easy-smart/stm32f1_nano/software/flasheuitest/README.md

# STM32F4 Uno flasheuitest

This test program is used to check the flash chip on SPI1. The chip used is a `SST26VF016BEUI-104I/SN` 16Mbit NOR-Flash
with EUI.

First, the EUI is written to SWO. Then a storage device is presented over USB where a file can be stored to the flash.

The blue LED pulses.
