easy-smart/stm32f1_nano/software/flashtest/README.md

# STM32F4 Uno flashtest

This test program is used to check the flash chip on SPI1. The chip used is a `W25Q128JVSIQ` 128Mbit NOR-Flash.

A storage device is presented over USB where a file can be stored to the flash.
