easy-smart/stm32f1_nano/production_jlcpcb_stm32f1_nano_2023-08-24_13-40-17/STM32F1 Nano Pinout.pdf

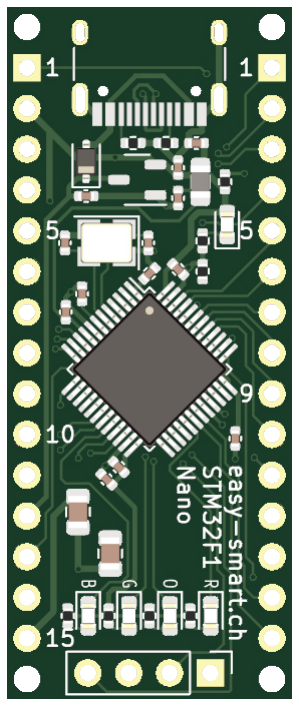
[picture p3: figure]

PB14
PB15
PB12
PC13
PB9
PB8
PB7
PB6
PB5
PB4
PA15
GND

PA10
PA9

DIO

CLK

SWO

GND

PB13
3V3

PA0
PA1
PA2
PA3
PB11
PB10
PB0
PB1

(from USB or LDO) 5V
nRST
GND

(4.8V..15.3V) V

# STM32F1 Nano v1.0.1

Software-Entwicklung
Informatik
3D-Druck
Elektronik
Automatisierung
