easy-smart/stm32f1_nano/production/jlcpcb_STM32F1_Nano_1.1.0_2023-10-03_12-36-29/Produce_DanZhi.SMT_Original_Snapshot.Top.4825844A_Y17.SMT02310031417711.png

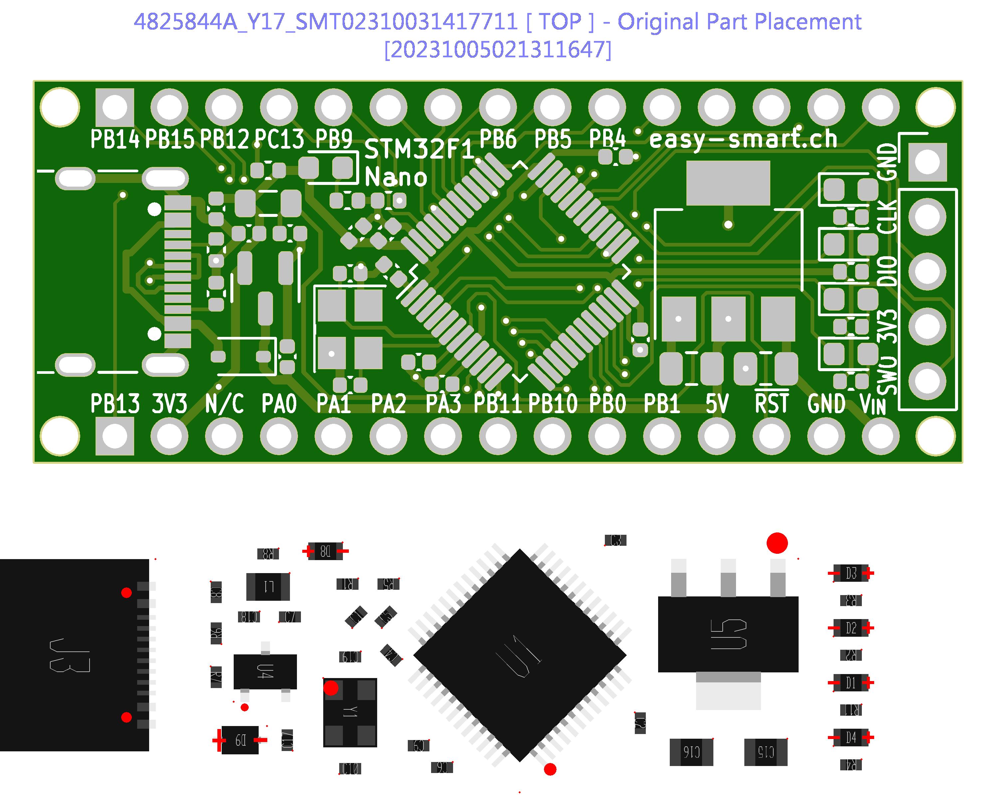
production/jlcpcb_STM32F1_Nano_1.1.0_2023-10-03_12-36-29/Produce_DanZhi.SMT_Original_Snapshot.Top.4825844A_Y17.SMT02310031417711.png
