easy-smart/stm32f1_nano/production/jlcpcb_STM32F1_Nano_1.1.0_2023-10-03_12-36-29/PXL_20240223_161416495.jpg

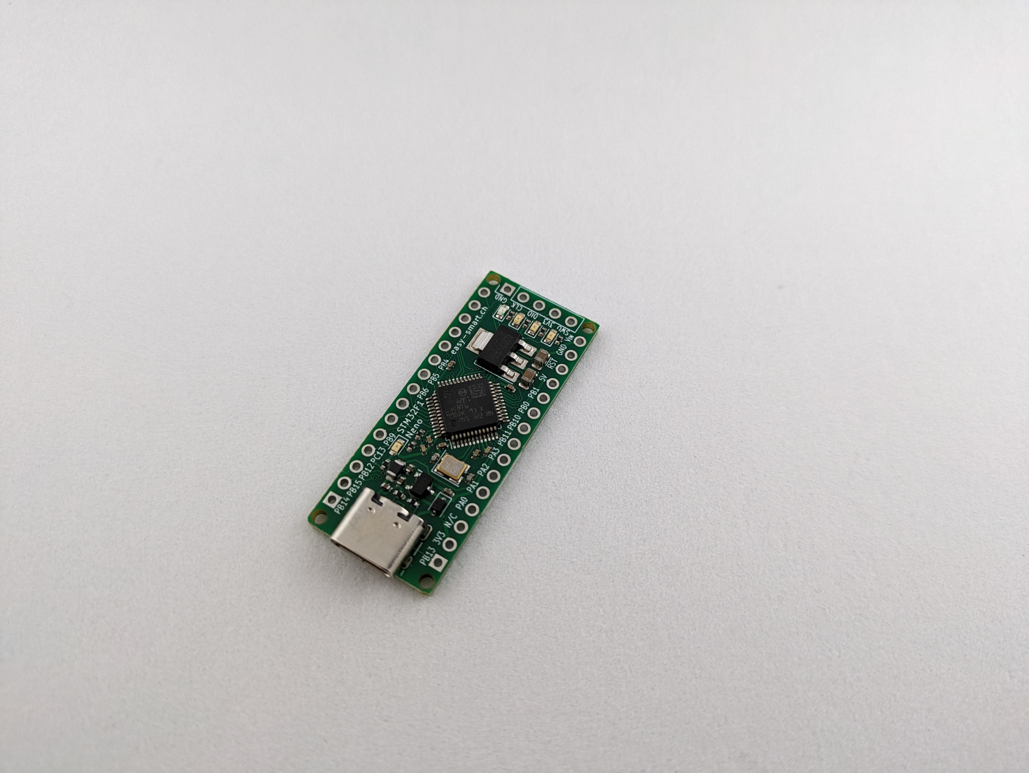
production/jlcpcb_STM32F1_Nano_1.1.0_2023-10-03_12-36-29/PXL_20240223_161416495.jpg
