easy-smart/stm32f1_nano/production_jlcpcb_stm32f1_nano_2023-08-24_13-40-17/Produce_DanZhi.SMT_Snapshot.Top.4825844A_Y10.SMT02308241367407.png

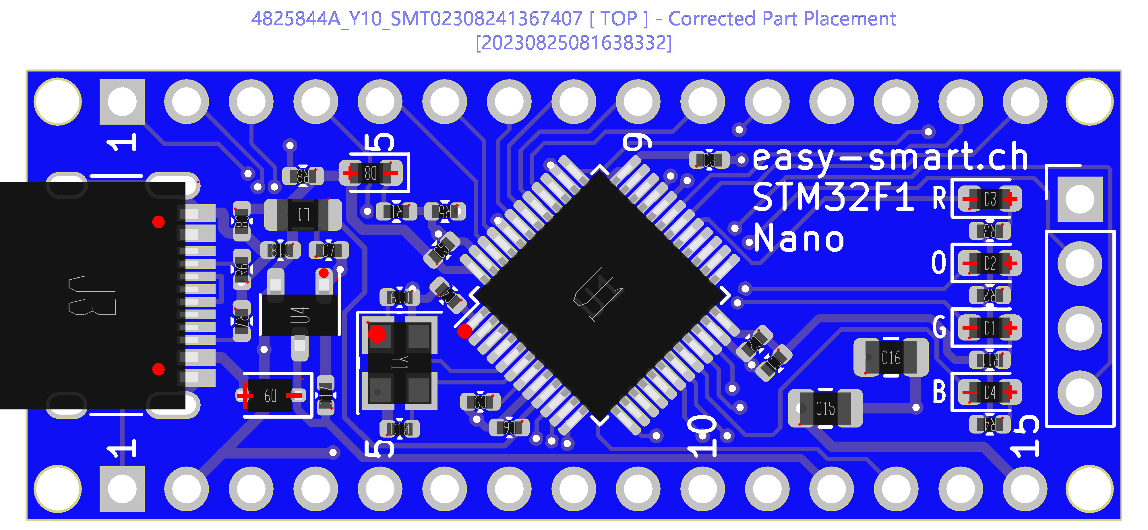
production_jlcpcb_stm32f1_nano_2023-08-24_13-40-17/Produce_DanZhi.SMT_Snapshot.Top.4825844A_Y10.SMT02308241367407.png
