easy-smart/stm32f1_nano/stm32f1_nano.kicad_pcb

## KiCad design stm32f1_nano.kicad_pcb (2023-10-03)

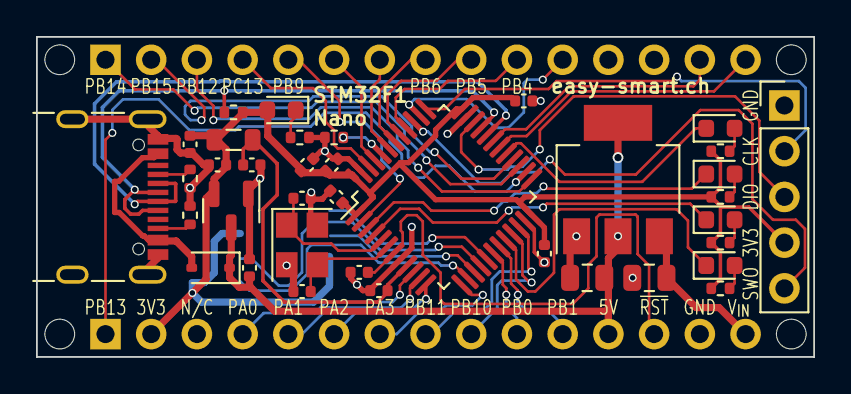
[picture p22: board stm32f1_nano.kicad_pcb from above]

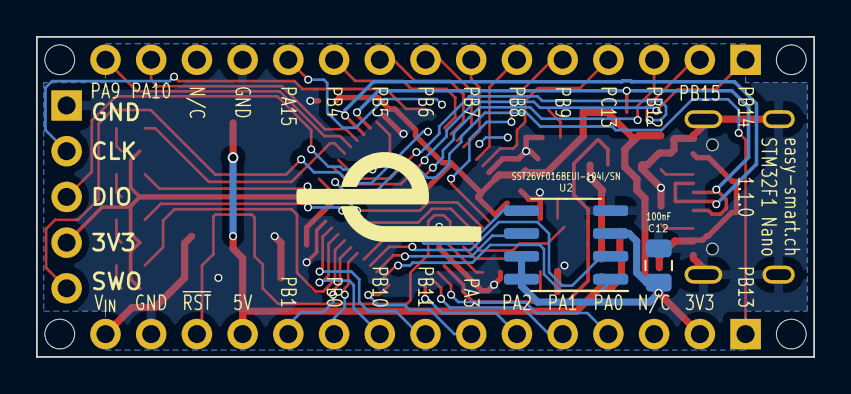
[picture p23: board stm32f1_nano.kicad_pcb from below]

Board: 2 copper layers, 43.2 x 17.8 mm, 45 parts (4 on the bottom side), 52 nets.

Parts:
C1, C6: 10n 50V; C_0402_1005Metric
C2, C3, C4, C5, C9: 100n 16V; C_0402_1005Metric
C7, C8, C17, C18: 1u 25V; C_0402_1005Metric
C10, C19: 20p 50V; C_0402_1005Metric
C12: 100nF; C_0805_2012Metric
C15, C16: 22u 25V; C_0805_2012Metric
D1: LED green; LED_0603_1608Metric
D2: LED yellow; LED_0603_1608Metric
D3: LED red; LED_0603_1608Metric
D4: LED blue; LED_0603_1608Metric
D8: PWR LED (grn); LED_0603_1608Metric
D9: 1N5819WS; D_SOD-323
J1: Analog; PinHeader_1x15_P2.54mm_Vertical
J2: Digital; PinHeader_1x15_P2.54mm_Vertical
J3: TYPE-C-31-M-12; SHOU HAN TYPE-C 16PIN 2MD(073)
J5: DEBUG; PinHeader_1x05_P2.54mm_Vertical
L1: 600Ω@100MHz; L_0805_2012Metric
MH1, MH2, MH3, MH4: MountingHole_65mil
R1, R11: 200; R_0402_1005Metric
R2, R3: 330; R_0402_1005Metric
R4: 150; R_0402_1005Metric
R5: 10k; R_0402_1005Metric
R6, R7: 5k1; R_0402_1005Metric
R8: 1k5; R_0402_1005Metric
U1: STM32F103C8T6; LQFP-48_7x7mm_P0.5mm
U2: SST26VF016BEUI-104I/SN; SOIC-8_3.9x4.9mm_P1.27mm
U4: XC6206P332MR; SOT-23
U5: AMS1117-5.0; SOT-223-3_TabPin2
Y1: X322516MLB4SI; Crystal_SMD_3225-4Pin_3.2x2.5mm

Connections:
+3.3V: C1.1, C2.1, C3.1, C4.1, C5.1, C8.1, C12.2, C18.1, D8.2 (A), J1.2, J5.4, L1.2, R2.2, R3.2, R4.2, R8.1, R11.2, U1.1 (VBAT), U1.24 (VDD), U1.36 (VDD), U1.48 (VDD), U2.3 (~WP), U2.7 (~HOLD), U2.8 (VDD), U4.2 (VO)
+3.3VA: C6.1, C7.1, L1.1, U1.9 (VDDA)
+5V: C16.1, C17.1, D9.1 (K), J1.12, U4.3 (VI), U5.2 (VO)
+12V: C15.1, J1.15, U5.3 (VI)
/BOOT0: R5.1, U1.44 (BOOT0)
/HSE_IN: C19.2, U1.5 (PD0), Y1.1
/HSE_OUT: C10.2, U1.6 (PD1), Y1.3
/LED1_GRN: D1.1 (K), U1.4 (PC15)
/LED2_ORG: D2.1 (K), U1.3 (PC14)
/LED3_RED: D3.1 (K), U1.29 (PA8)
/LED4_BLU: D4.1 (K), U1.20 (PB2)
/PA0: J1.4, U1.10 (PA0)
/PA1: J1.5, U1.11 (PA1)
/PA2: J1.6, U1.12 (PA2)
/PA3: J1.7, U1.13 (PA3)
/PA9: J2.15, U1.30 (PA9)
/PA10: J2.14, U1.31 (PA10)
/PA15: J2.11, U1.38 (PA15)
/PB0: J1.10, U1.18 (PB0)
/PB1: J1.11, U1.19 (PB1)
/PB4: J2.10, U1.40 (PB4)
/PB5: J2.9, U1.41 (PB5)
/PB6: J2.8, U1.42 (PB6)
/PB7: J2.7, U1.43 (PB7)
/PB8: J2.6, U1.45 (PB8)
/PB9: J2.4, U1.46 (PB9)
/PB10: J1.9, U1.21 (PB10)
/PB11: J1.8, U1.22 (PB11)
/PB12: J2.3, U1.25 (PB12)
/PB13: J1.1, U1.26 (PB13)
/PB14: J2.1, U1.27 (PB14)
/PB15: J2.2, U1.28 (PB15)
/PC13: J2.5, U1.2 (PC13)
/SPI1_MISO: U1.16 (PA6), U2.2 (SO)
/SPI1_MOSI: U1.17 (PA7), U2.5 (SI)
/SPI1_NSS: U1.14 (PA4), U2.1 (~CE)
/SPI1_SCK: U1.15 (PA5), U2.6 (SCK)
/USB_D+: J3.A6 (D+), J3.B6 (D+), R8.2, U1.33 (PA12)
/USB_D-: J3.A7 (D-), J3.B7 (D-), U1.32 (PA11)
/~RESET: C9.1, J1.13, U1.7 (NRST)
GND: C1.2, C2.2, C3.2, C4.2, C5.2, C6.2, C7.2, C8.2, C9.2, C10.1, C12.1, C15.2, C16.2, C17.2, C18.2, C19.1, J1.14, J2.12, J3.A1 (GND), J3.A12 (GND), J3.B1 (GND), J3.B12 (GND), J3.S1 (SHIELD), J5.1, R1.1, R5.2, R6.1, R7.1, U1.8 (VSSA), U1.23 (VSS), U1.35 (VSS), U1.47 (VSS), U2.4 (VSS), U4.1 (GND), U5.1 (GND), Y1.2, Y1.4
unnamed: D1.2 (A), R11.1
unnamed: D2.2 (A), R2.1
unnamed: D3.2 (A), R3.1
unnamed: D4.2 (A), R4.1
unnamed: D8.1 (K), R1.2
unnamed: J3.A5 (CC1), R6.2
unnamed: J3.B5 (CC2), R7.2
SWCLK: J5.2, U1.37 (PA14)
SWDIO: J5.3, U1.34 (PA13)
SWO: J5.5, U1.39 (PB3)
VBUS: D9.2 (A), J3.A4 (VBUS), J3.A9 (VBUS), J3.B4 (VBUS), J3.B9 (VBUS)
