easy-smart/stm32f1_nano/doc/stm32f1_nano.ioc

Mcu.UserName=STM32F103C8Tx
PA0-WKUP.GPIO_Label=A0/D14(*)
PA0-WKUP.Signal=ADCx_IN0
PA1.GPIO_Label=A1/D15(*)
PA1.Signal=ADCx_IN1
PA10.GPIO_Label=USART1_RX/D0(*)
PA10.Signal=USART1_RX
PA11.Signal=USB_DM
PA12.Signal=USB_DP
PA13.Signal=SYS_JTMS-SWDIO
PA14.Signal=SYS_JTCK-SWCLK
PA15.GPIO_Label=D2(*)
PA15.Signal=GPIO_Output
PA2.GPIO_Label=A2/D16(*)
PA2.Signal=ADCx_IN2
PA3.GPIO_Label=A3/D17(*)
PA3.Signal=ADCx_IN3
PA4.Signal=SPI1_NSS
PA5.Signal=SPI1_SCK
PA6.Signal=SPI1_MISO
PA7.Signal=SPI1_MOSI
PA8.GPIO_Label=LED3_RED
PA8.Signal=GPIO_Output
PA9.GPIO_Label=USART1_TX/D1(*)
PA9.Signal=USART1_TX
PB0.GPIO_Label=A6/D20(*)
PB0.Signal=ADCx_IN8
PB1.GPIO_Label=A7/D21(*)
PB1.Signal=ADCx_IN9
PB10.GPIO_Label=I2C2_SCL/A5/D19(*)
PB10.Signal=I2C2_SCL
PB11.GPIO_Label=I2C2_SDA/A4/D18(*)
PB11.Signal=I2C2_SDA
PB12.GPIO_Label=SPI2_NSS/D10\!*
PB12.Signal=SPI2_NSS
PB13.GPIO_Label=SPI2_SCK/D13(*)
PB13.Signal=SPI2_SCK
PB14.GPIO_Label=SPI2_MISO/D12(*)
PB14.Signal=SPI2_MISO
PB15.GPIO_Label=SPI2_MOSI/D11*
PB15.Signal=SPI2_MOSI
PB2.GPIO_Label=LED4_BLU
PB2.Signal=GPIO_Output
PB3.Signal=SYS_JTDO-TRACESWO
PB4.GPIO_Label=D3*
PB4.Signal=GPIO_Analog
PB5.GPIO_Label=D4(*)
PB5.Signal=GPIO_Output
PB6.GPIO_Label=D5*
PB6.Signal=GPIO_Analog
PB7.GPIO_Label=D6*
PB7.Signal=GPIO_Analog
PB8.GPIO_Label=D7(*)
PB8.Signal=GPIO_Output
PB9.GPIO_Label=D9*
PB9.Signal=GPIO_Output
PC13-TAMPER-RTC.GPIO_Label=D8
PC13-TAMPER-RTC.Signal=GPIO_Analog
PC14-OSC32_IN.GPIO_Label=LED2_ORG
PC14-OSC32_IN.Signal=GPIO_Output
PC15-OSC32_OUT.GPIO_Label=LED1_GRN
PC15-OSC32_OUT.Signal=GPIO_Output
PD0-OSC_IN.Signal=RCC_OSC_IN
PD1-OSC_OUT.Signal=RCC_OSC_OUT
