easy-smart/stm32f1_nano/(commit log)

2023-08-21 First draft
    [stm32f1_nano.kicad_pcb, stm32f1_nano.kicad_sch]
2023-08-22 First draft almost done
    [stm32f1_nano.kicad_pcb, stm32f1_nano.kicad_sch]
2023-08-22 New PS
    [stm32f1_nano.kicad_pcb, stm32f1_nano.kicad_sch]
2023-08-22 Reassigned Pins
    [stm32f1_nano.kicad_pcb, stm32f1_nano.kicad_sch]
2023-08-23 Almost done
    [stm32f1_nano.kicad_pcb, stm32f1_nano.kicad_sch]
2023-08-23 First Version released to production
    [bom.csv, designators.csv, positions.csv, stm32f1_nano.kicad_pcb, stm32f1_nano.kicad_sch]
2023-08-24 Corrected distance drill-to-drill and drill-to-track
    [bom.csv, designators.csv, positions.csv, stm32f1_nano.kicad_pcb]
2023-08-30 Test Software
    [stm32f103c8_blue_pill.cfg]
2023-09-01 Test for SWO
    [stm32f103c8_blue_pill.cfg]
2023-09-05 Change path, SWO successful
    [stm32f103c8_blue_pill.cfg]
2023-09-05 Add usbtest
    [stm32f103c8_blue_pill.cfg]
2023-09-05 Add flashtest
    [stm32f103c8_blue_pill.cfg]
2023-09-05 #2 green and red LED are too bright
    [stm32f1_nano.kicad_pcb, stm32f1_nano.kicad_sch]
2023-09-05 #3 Make C12 bigger or move to Front
    [stm32f1_nano.kicad_pcb, stm32f1_nano.kicad_sch]
2023-09-05 Change version
    [stm32f1_nano.kicad_pcb, stm32f1_nano.kicad_sch]
2023-09-05 #1 Make debug pins compatible with BluePill
    [stm32f1_nano.kicad_pcb, stm32f1_nano.kicad_sch]
2023-09-05 #5 Check PWM pins
    [stm32f1_nano.kicad_pcb, stm32f1_nano.kicad_sch]
2023-09-05 #4 Can U5 be moved to Front?
    [stm32f1_nano.kicad_pcb]
2023-09-06 #6 Check RX/TX
    [stm32f103c8_blue_pill.cfg]
2023-09-20 #11 Use new central library KiCad-Lib
    [stm32f1_nano.kicad_pcb, stm32f1_nano.kicad_sch]
2023-09-20 #10 Change USB connector to SHOU HAN TYPE-C 16PIN 2MD(073) (C2765186)
    [stm32f1_nano.kicad_pcb, stm32f1_nano.kicad_sch]
2023-09-20 #8 Use green power led
    [stm32f1_nano.kicad_pcb, stm32f1_nano.kicad_sch]
2023-09-20 #7 Change W25 for a SST26
    [stm32f1_nano.kicad_pcb, stm32f1_nano.kicad_sch]
2023-09-20 Fix missing 3V3 track
    [stm32f1_nano.kicad_pcb]
2023-09-20 Add PCB 3D model
    [stm32f1_nano.kicad_pcb]
2023-09-29 Add picture of stm32f1_nano on nano din rail box
2023-10-01 #12 Add pin description to front
    [stm32f1_nano.kicad_pcb]
2023-10-03 Release 1.1.0 sent to JLCPCB
    [bom.csv, designators.csv, positions.csv, stm32f1_nano.kicad_pcb, stm32f1_nano.kicad_sch]
2023-10-03 PCB production confirmed
2023-10-12 #13 Implement flasheuitest
    [stm32f103c8_blue_pill.cfg]
