easy-smart/stm32f1_nano/doc/Nano on DIN Rail box.JPG

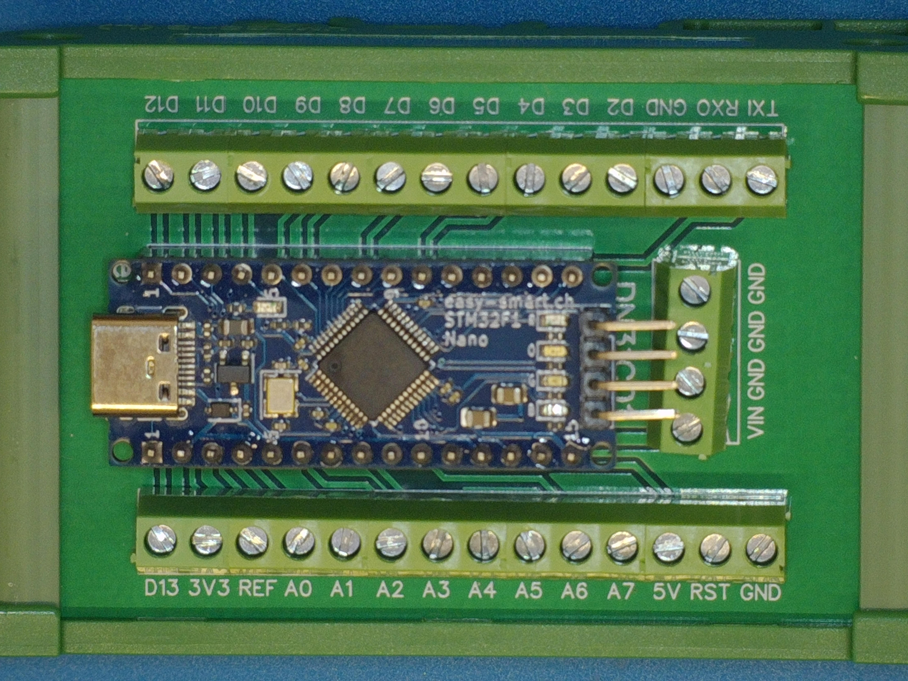
doc/Nano on DIN Rail box.JPG
