easy-smart/stm32f1_nano/production_jlcpcb_stm32f1_nano_2023-08-24_13-40-17/Photo Front Assembled.jpg

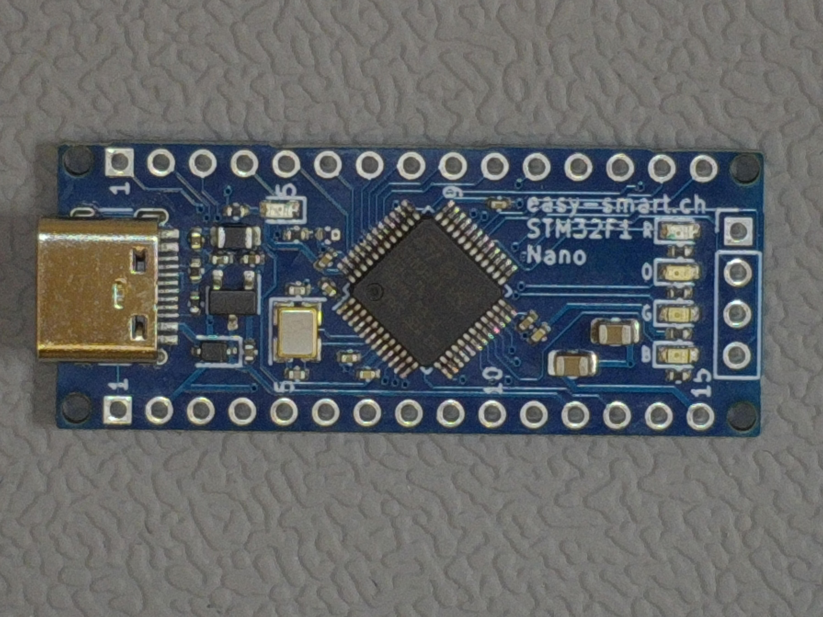
production_jlcpcb_stm32f1_nano_2023-08-24_13-40-17/Photo Front Assembled.jpg
